thayn/Liahona/cad/out/spindle_compare.png

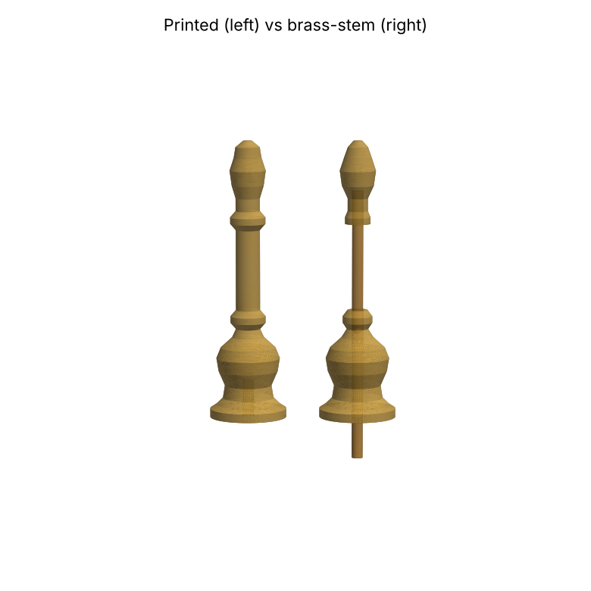
cad/out/spindle_compare.png
