thayn/Liahona/cad/out/v2_back.png

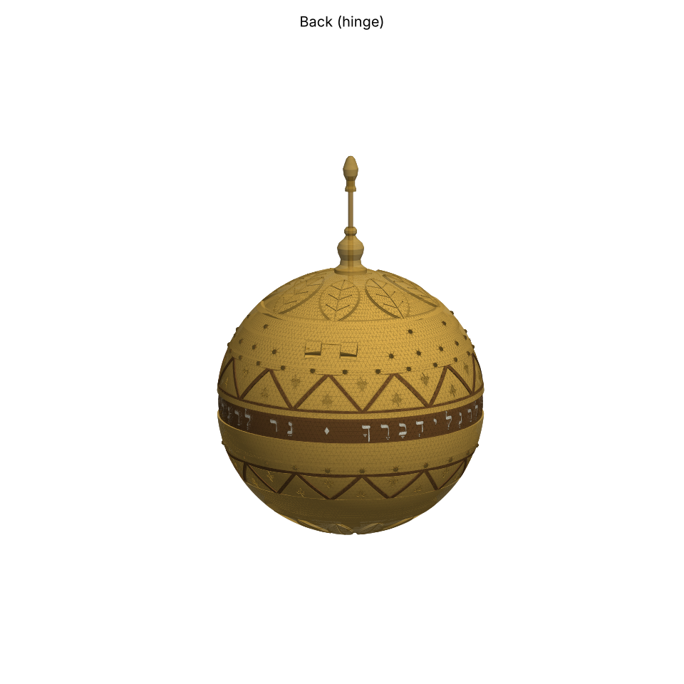
cad/out/v2_back.png
