thayn/Liahona/cad/out/v2_bottom.png

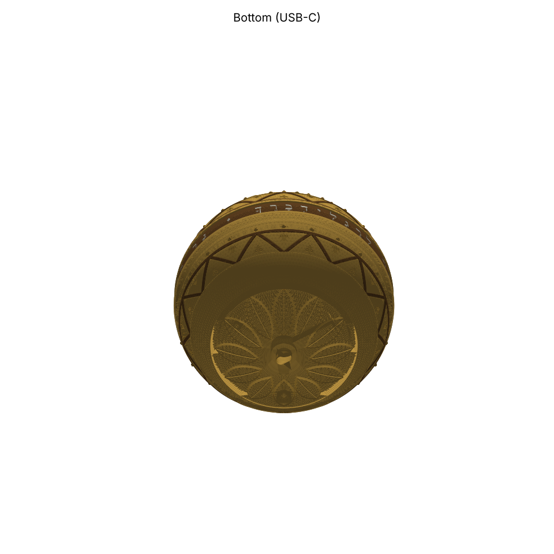
cad/out/v2_bottom.png
