thayn/Liahona/cad/out/v2_open.png

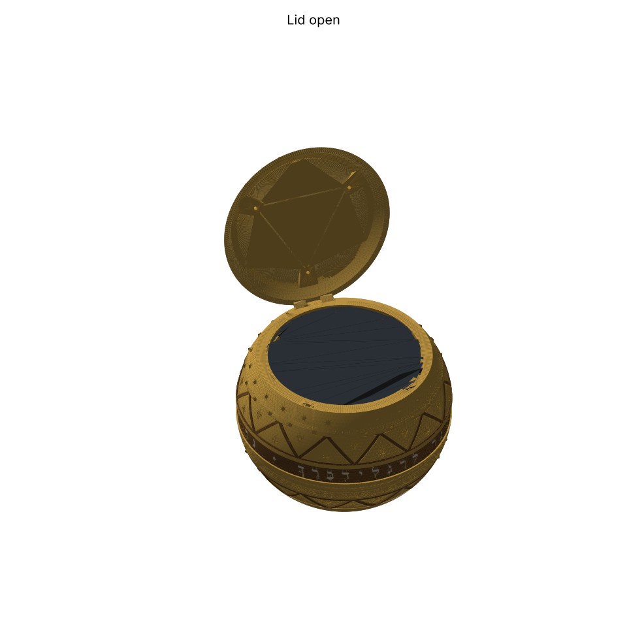
cad/out/v2_open.png
