thayn/Liahona/cad/out/v2_section_gps.png

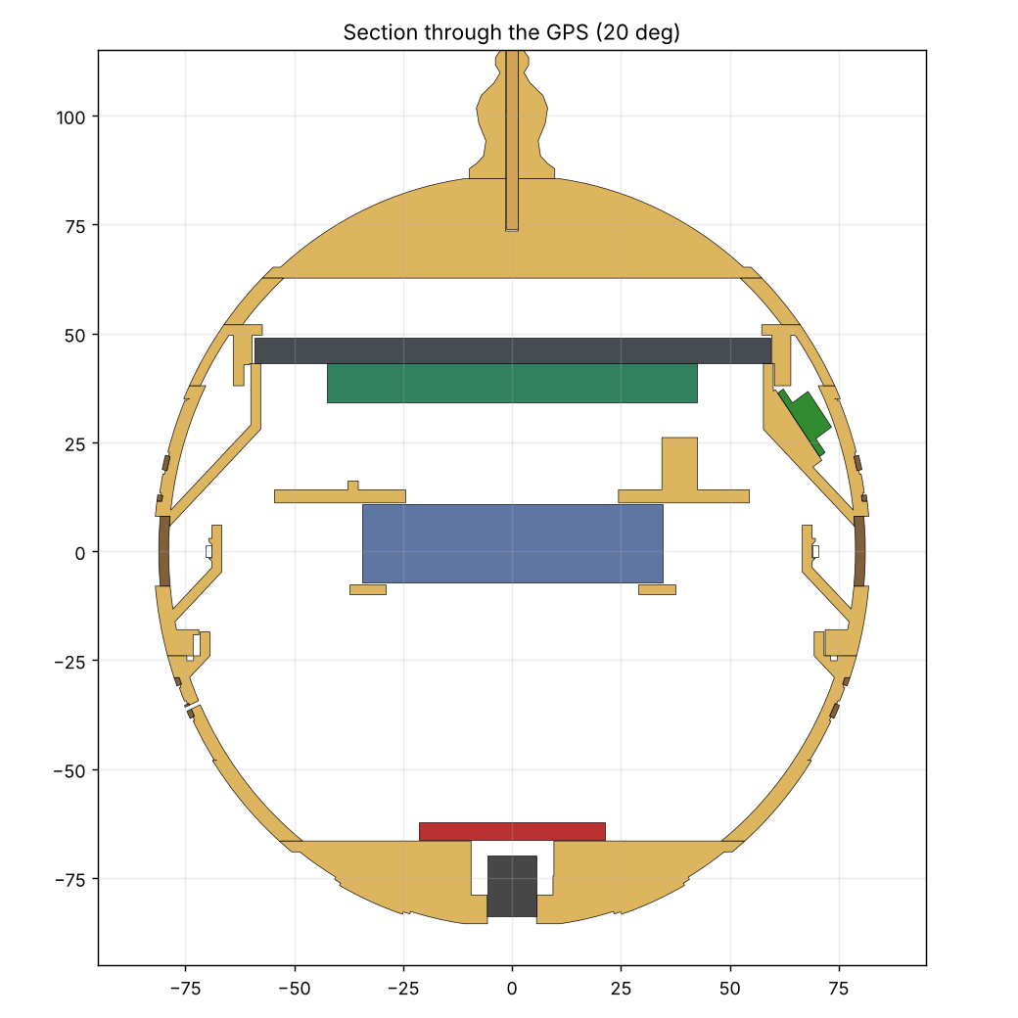
cad/out/v2_section_gps.png
