thayn/Liahona/cad/out/v2_section_x0.png

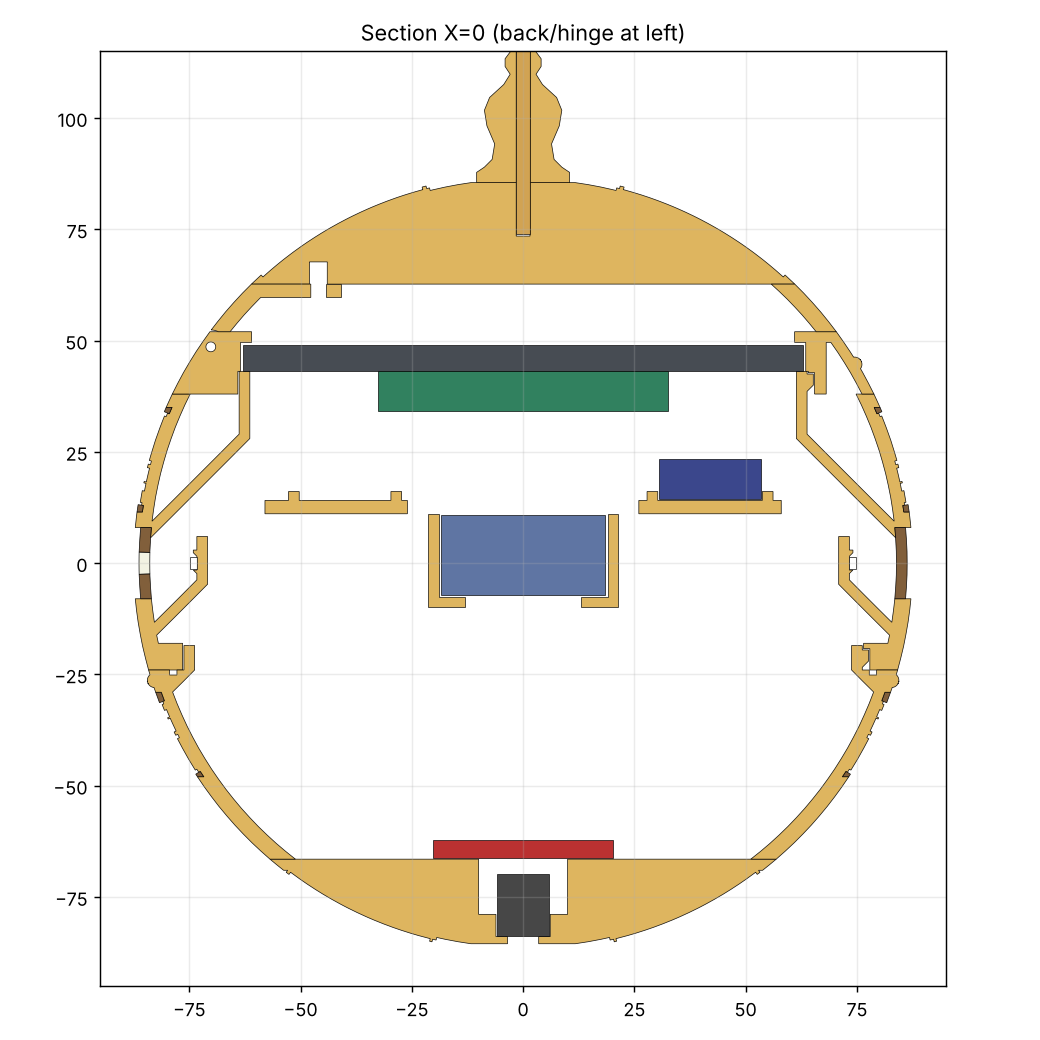
cad/out/v2_section_x0.png
