thayn/Liahona/docs/images/compass_preview.png

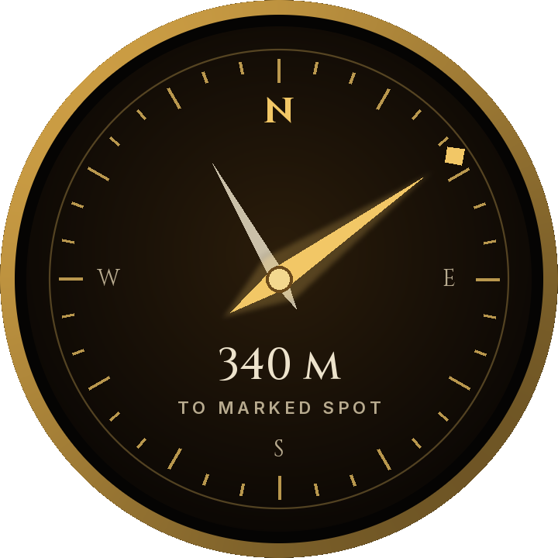
docs/images/compass_preview.png
