thayn/Liahona/cad/out/bezel_ring.3mf

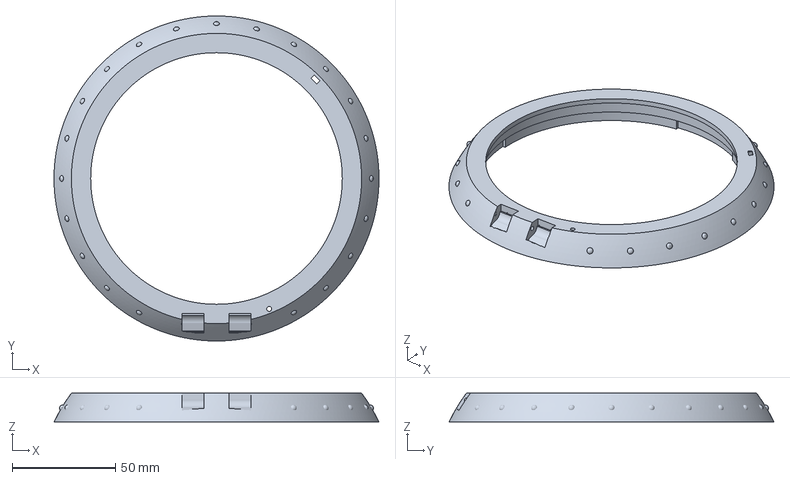
[picture p8: CAD file, 2026-11-10]
cad/out/bezel_ring.3mf
157.6 x 157.6 x 14.0 mm
