thayn/Liahona/cad/out/lower_shell.3mf

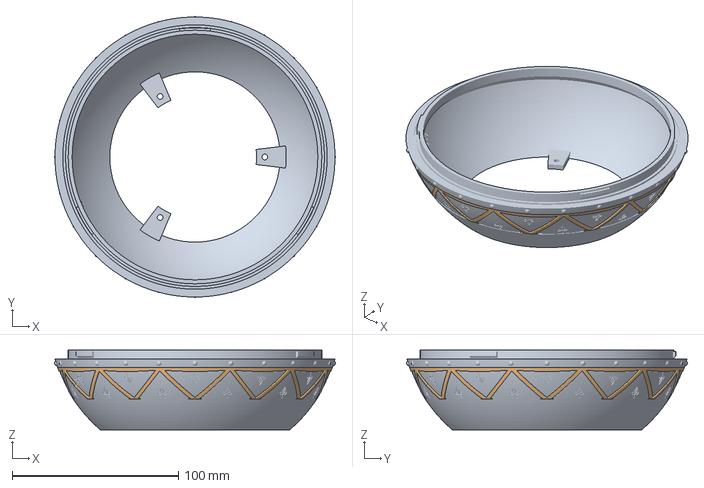
[picture p9: CAD file, 2026-11-10]
cad/out/lower_shell.3mf
168.9 x 168.9 x 48.0 mm
lower_shell_gold
lower_shell_tan
