thayn/Liahona/cad/out/spindle_printed.3mf

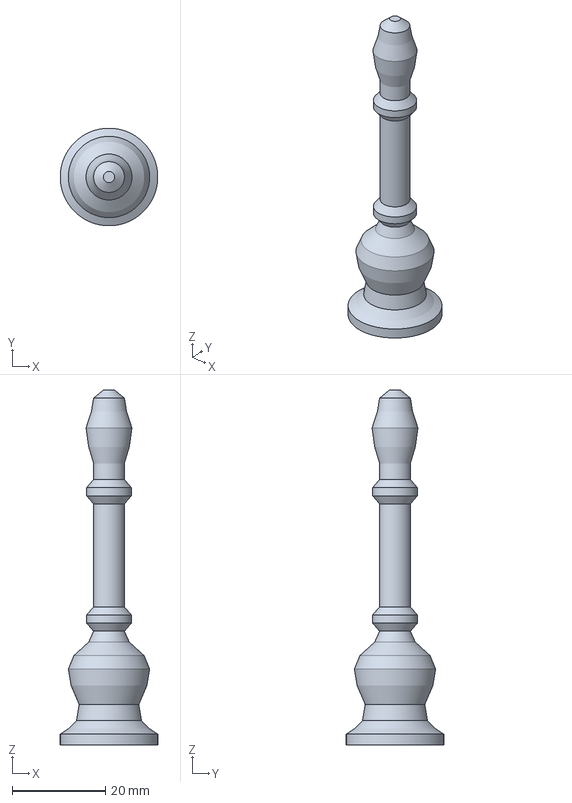
[picture p10: CAD file, 2026-11-10]
cad/out/spindle_printed.3mf
20.9 x 20.9 x 76.0 mm
