thayn/Liahona/cad/out/plunger.3mf

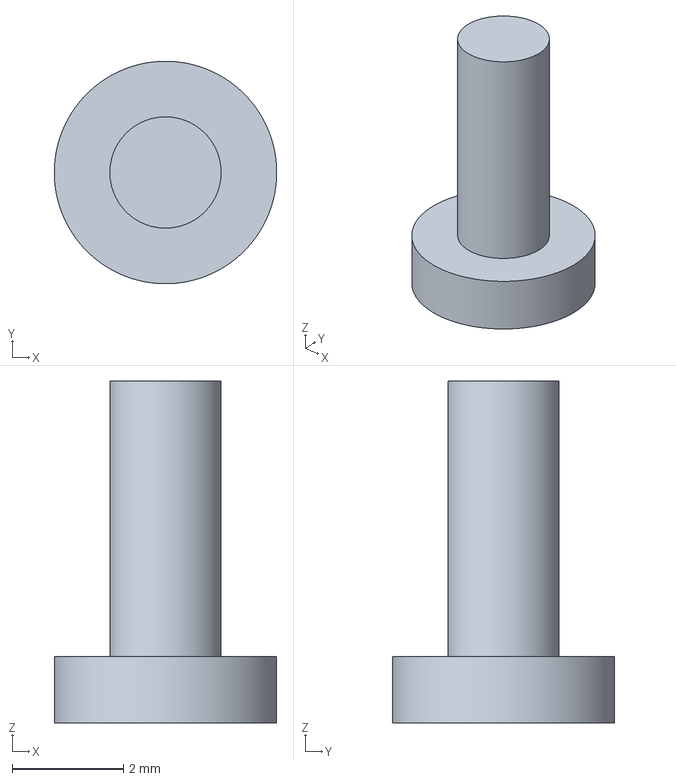
[picture p11: CAD file, 2026-11-10]
cad/out/plunger.3mf
4.00 x 4.00 x 6.15 mm
