thayn/Liahona/cad/out/upper_shell.3mf

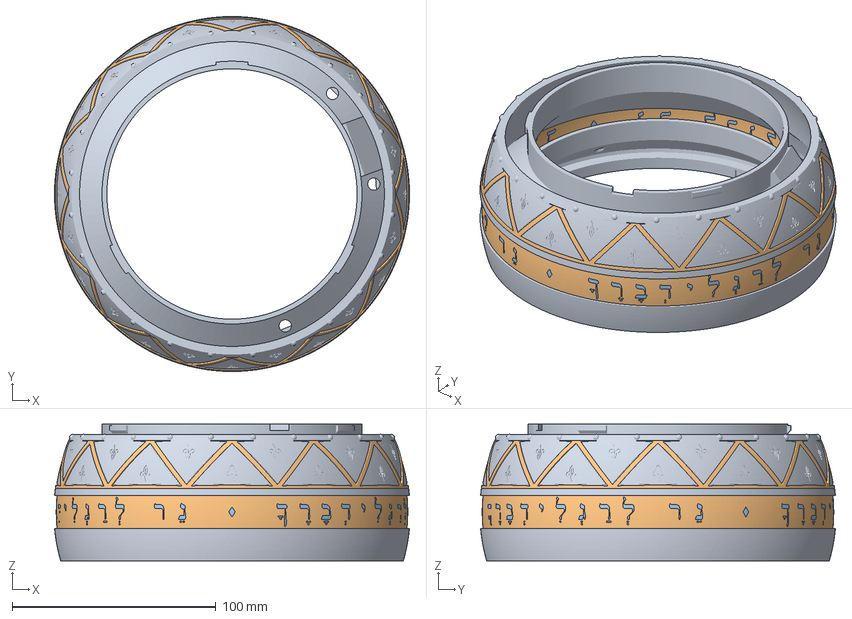
[picture p12: CAD file, 2026-11-10]
cad/out/upper_shell.3mf
174.3 x 174.3 x 67.1 mm
upper_shell_gold
upper_shell_tan
upper_shell_clear
