thayn/Liahona/cad/out/lid_cap.3mf

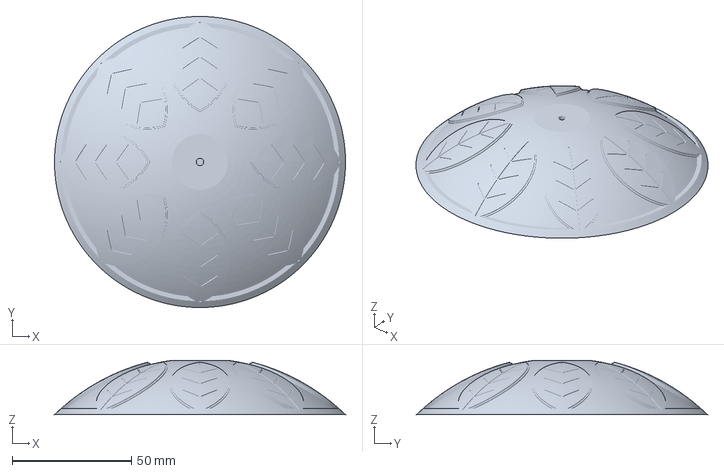
[picture p13: CAD file, 2026-11-10]
cad/out/lid_cap.3mf
122.1 x 122.1 x 22.8 mm
