thayn/Liahona/cad/out/battery_tray.3mf

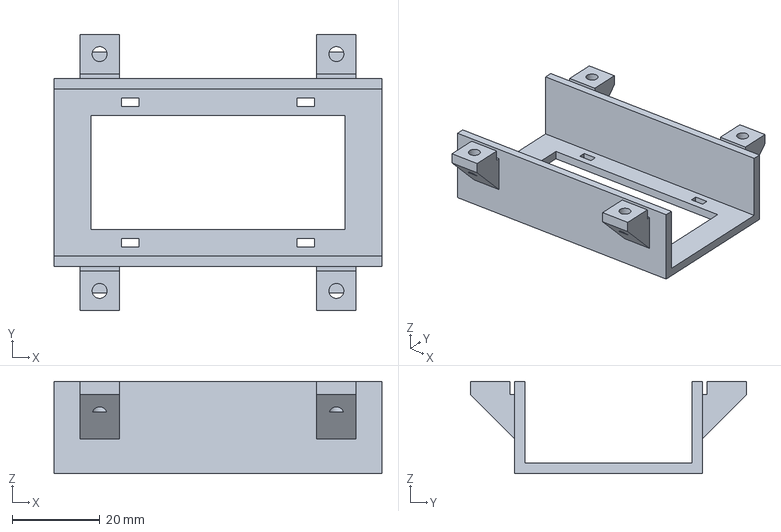
[picture p14: CAD file, 2026-11-10]
cad/out/battery_tray.3mf
74.8 x 63.0 x 21.0 mm
