thayn/Liahona/cad/out/base_cap.3mf

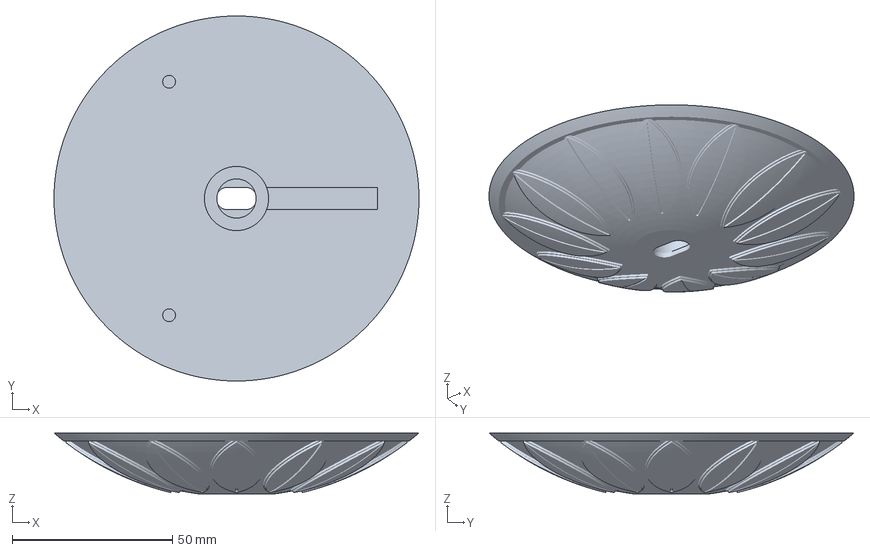
[picture p15: CAD file, 2026-11-10]
cad/out/base_cap.3mf
113.7 x 113.7 x 19.0 mm
