thayn/Liahona/cad/out/lid_ring.3mf

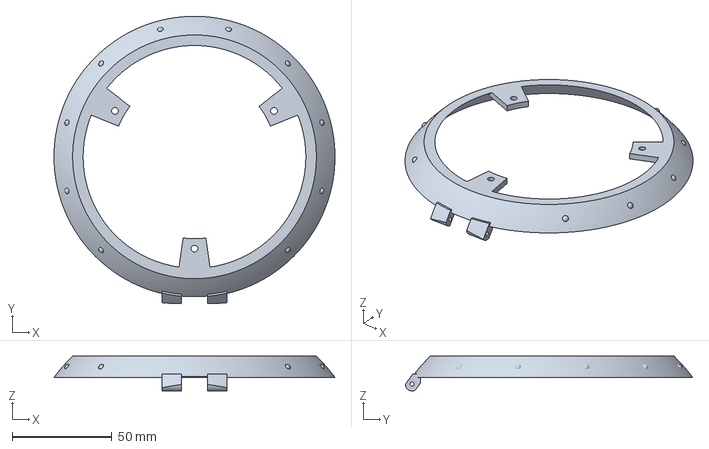
[picture p16: CAD file, 2026-11-10]
cad/out/lid_ring.3mf
140.7 x 143.9 x 17.5 mm
