thayn/Liahona/cad/out/chassis.3mf

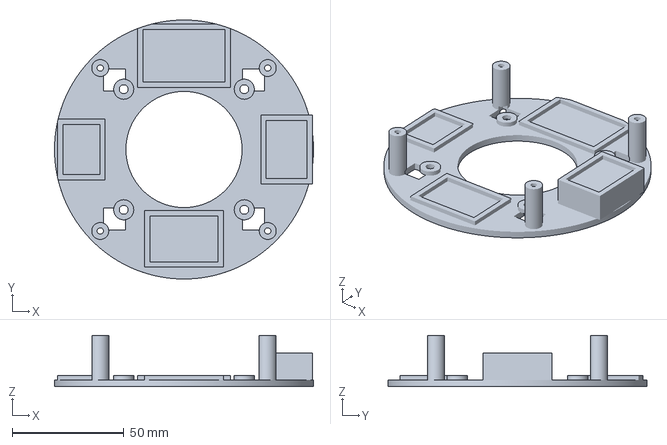
[picture p18: CAD file, 2026-11-10]
cad/out/chassis.3mf
116.0 x 116.0 x 23.0 mm
