thayn/Liahona/(commit log)

2026-11-10 Initial import: firmware v0.2.0, CAD v2, docs
    - firmware/: ESP-IDF project for the Waveshare ESP32-P4-WIFI6-Touch-LCD-4C
    (self-test page, concept-style compass, camp declination +14.3)
    - cad/: build123d model, 3MF print files and renders (STEP/STL regenerated)
    - docs/: CAD spec and Liahona Manager architecture
    Claude-Session: https://claude.ai/code/session_01NMCgoezPd53wTYz6APp8XK
    [base_cap.3mf, battery_tray.3mf, bezel_ring.3mf, chassis.3mf, lid_cap.3mf, lid_ring.3mf, lower_shell.3mf, partitions.csv]
2026-11-10 Compass: fix background colours, spindles over text
    - Background image showed red/blue swapped on hardware (brown -> navy); swap when packing
    - Draw dial and spindles above the heading/distance text
    - Move heading and caption up so N doesn't collide when north is down
    - Version 0.2.1
    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
    [ui_compass.c]
2026-11-10 Compass: gold spindle rests on north when no station is set
    The idle drift made the spindles move while the dial stayed still,
    which looked like a bug on the bench.
    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
    [ui_compass.c]
2026-11-10 Compass: fixed dial with N at the top, as in the concept
    Only the spindles turn now (thin = north, gold = station). Updated preview.
    Version 0.2.2.
    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
    [ui_compass.c]
2026-11-10 GPS: fix sentence splitting on I2C padding, verify checksums
    The PA1010D pads its I2C output with lone LF bytes when idle; these were
    treated as line ends and cut sentences in half. Only CR LF ends a sentence now.
    Also checks NMEA checksums and logs fix/used/in-view every 5 s. v0.2.3.
    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
    [gps.c]
2026-11-10 GPS diagnostics: signal strength log and screen-off noise test
    - Log satellites heard and best SNR per 5 s
    - Tap the GPS row on the self-test page: backlight off for 60 s
    - GPS I2C at 100 kHz for long test leads
    v0.2.4
    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
    [gps.c, liahona.h, ui.c]
